HexabitzPlatform/H1FR5x-Hardware/README.md

# H1FR50-Hardware
Hexabitz SAM-M10Q GNSS Module Hardware Design
