HexabitzPlatform/H1FR5x-Hardware/H1FR50/Released/BOM/H1FR50.xlsx

 |  | www.hexabitz.com info@hexabitz.com |  |  | Bill Of Materials
Customer | Hexabitz | Revision | 0
Project | Hexabitz Modules | Date | 2022-09-11
Board | GPS Module (H1FR50) | Notes
Designator | Description | Manufacturer Part Number | Manufacturer | Octopart Url | Quantity
JP1 | PCB Header, Unshrouded, Thru 02 Straight Header, .101, AMPMODU Mod II Series | 87227-1 | TE Connectivity | https://octopart.com/87227-1-te+connectivity-39512052?r=sp | 1
JP2 | Conn Unshrouded Header HDR 3 POS 2.54mm Solder ST Top Entry Thru-Hole Carton | 5-146281-3 | TE Connectivity | https://octopart.com/5-146281-3-te+connectivity+%2F+amp-39745942?r=sp | 1
R2 | RES SMD 0.0OHM JUMPER 1/10W 0603 | RC0603JR-070RL | YAGEO [VR] | https://octopart.com/rc0603jr-070rl-yageo-1241539?r=sp | 1
R8 , R9 | Res Thick Film 0603 150 Ohm 1% 0.1W(1/10W) +/-100ppm/ßC Pad SMD Automotive T/R | CRCW0603150RFKEA | Vishay | https://octopart.com/crcw0603150rfkea-vishay-39455211?r=sp | 2
R3 | Thick Film Resistors - SMD 0603 270 Ohm 5% Tol | ERJ-3GEYJ271V | Panasonic | https://octopart.com/erj-3geyj271v-panasonic-55560546?r=sp | 1
R1 , R4 , R5 , R6 , R7 | RES 10K Ohm 5% 0603 | CRCW060310K0JNEB | Vishay | https://octopart.com/crcw060310k0jneb-vishay-46603269 | 7
C1, C3 , C5 , C6 , C8, C10 , C12 | CAP CER 0.1 UF 10% X7R 0603 | C0603C104K8RACTU | KEMET | https://octopart.com/c0603c104k8ractu-kemet-145075?r=sp&s=9bS9ASSwSEqMCE9KBEQZ0g | 7
C4 | CAP CER 1 UF 16V X7R 0805 | CC0805KKX7R7BB105 | YAGEO [VA] | https://octopart.com/cc0805kkx7r7bb105-yageo-8376555?r=sp | 1
C2 ,C7 , C9 , C11 , C13 | CAP TANT 4.7 UF 10V 20% 0805 | 10TPU4R7MSI | Panasonic | https://octopart.com/10tpu4r7msi-panasonic-29487748?r=sp | 5
FB1 | Ind chip Bead Multi-Layer 30 ohms 25% 100MHZ Ferrite 1,5A 0603Punched paper T/R | MMZ1608Y300BTA00 | TDK | https://octopart.com/mmz1608y300bta00-tdk-7906990?r=sp | 1
FB2 , FB3 | Ferrite Beads Multi-Layer 600Ohm 25% 100MHz 1.3A 150mOhm DCR 0603 Paper T/R | BLM18KG601SN1D | Murata | https://octopart.com/blm18kg601sn1d-murata-12276433?r=sp | 2
D1 | Red 0603 130° Clear 54 mcd 2 V Surface Mount ChipLED | VLMS1300-GS08 | Vishay | https://octopart.com/vlms1300-gs08-vishay-21709201?r=sp&s=0nXJNjGsSbWwqfqWlZv0EA | 1
Q1 , Q2 | Transistor, Bipolar, Si, NPN, General Purpose, VCEO 40VDC, IC 200mA, PD 225mW, SOT-23 | MMBT3904LT1G | ON Semiconductor | https://octopart.com/mmbt3904lt1g-on+semiconductor-3280?r=sp | 2
U1 | MCU 32-Bit ARM Cortex-M0+ RISC 512kByte Flash 1.7V to 3.6V 48-Pin UFQFPN Tray | STM32G0B1CEU6N | STMicroelectronics | https://octopart.com/stm32g0b1ceu6n-stmicroelectronics-116364672?r=sp | 1
U2 | u-blox M10 GNSS antenna module ROM, TCXO, SAW, LNA LGA | SAM-M10Q-00B | u-blox | https://octopart.com/sam-m10q-00b-u-blox-130040883?r=sp | 1
X1 | 8,0000MHZ 33pF SMD MURATA Resonators | CSTNE8M00G550000R0 | Murata | https://octopart.com/cstne8m00g550000r0-murata-91406934?r=sp | 1
