HexabitzPlatform/H1FR5x-Hardware/H1FR50/Documentation/H1FR50.pdf

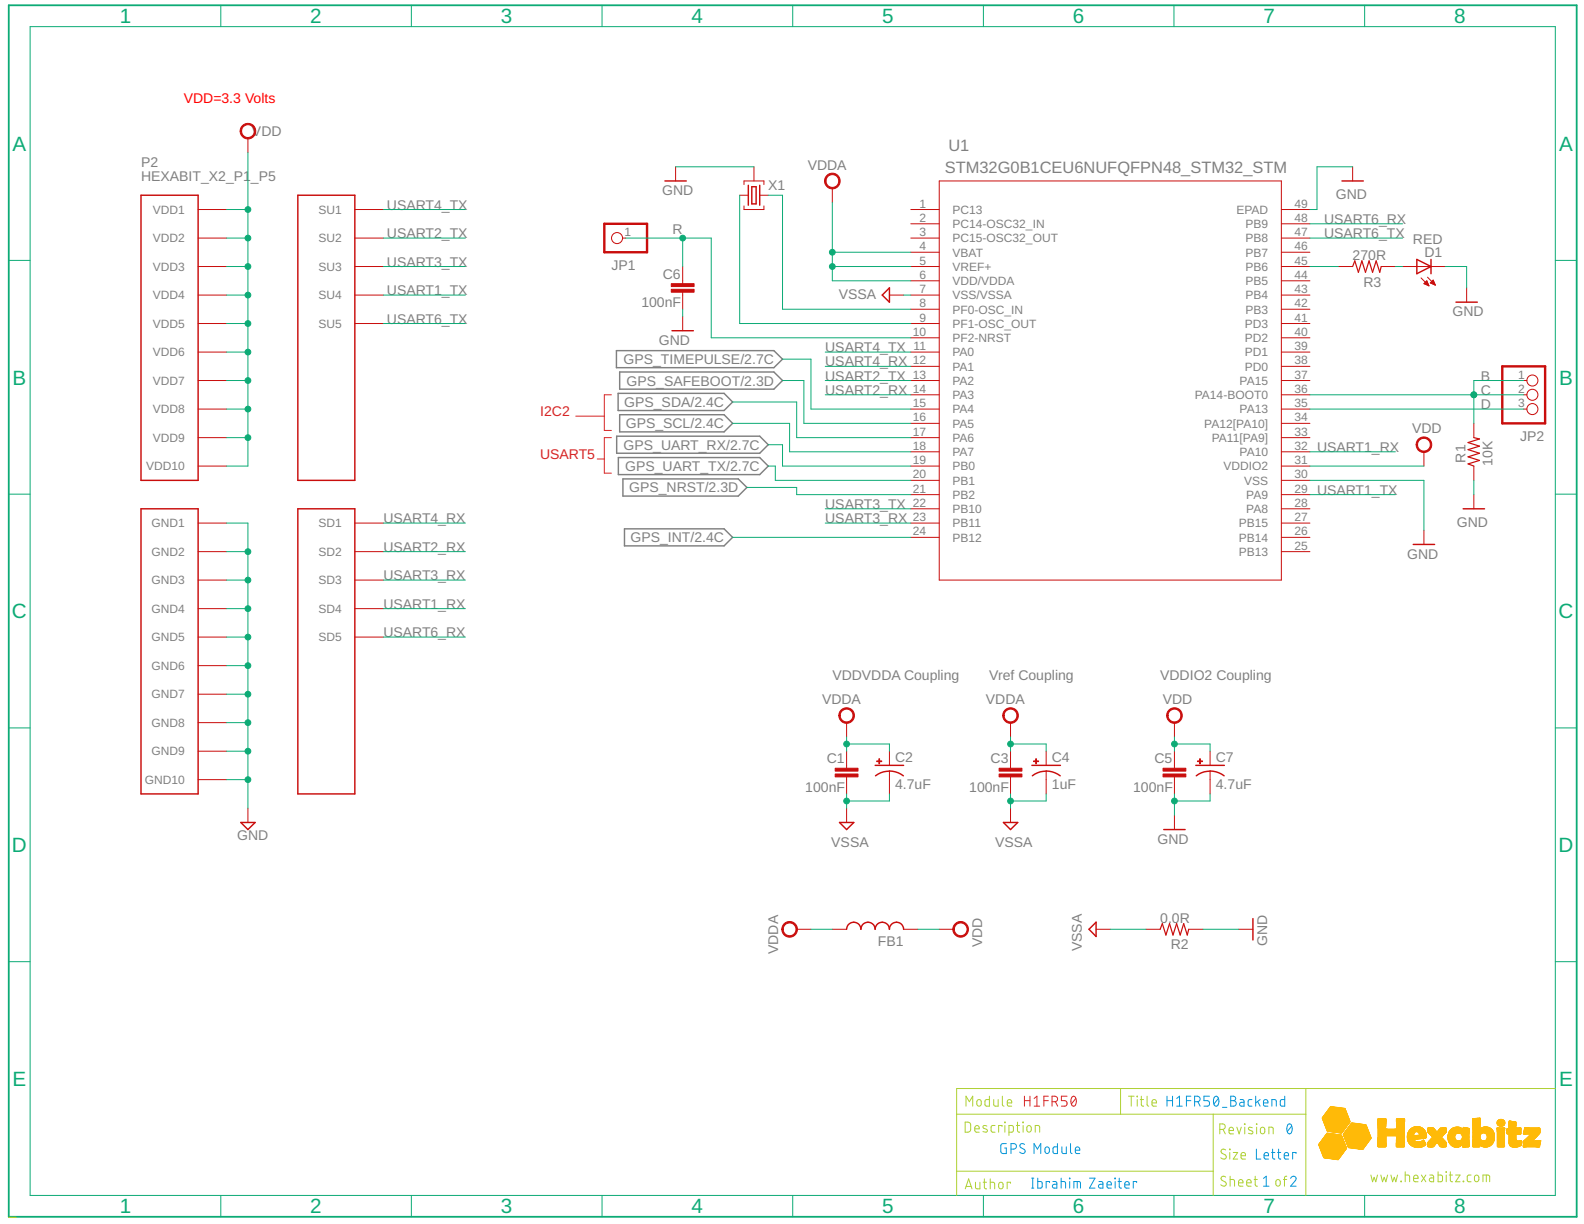
[picture p1: page 1]

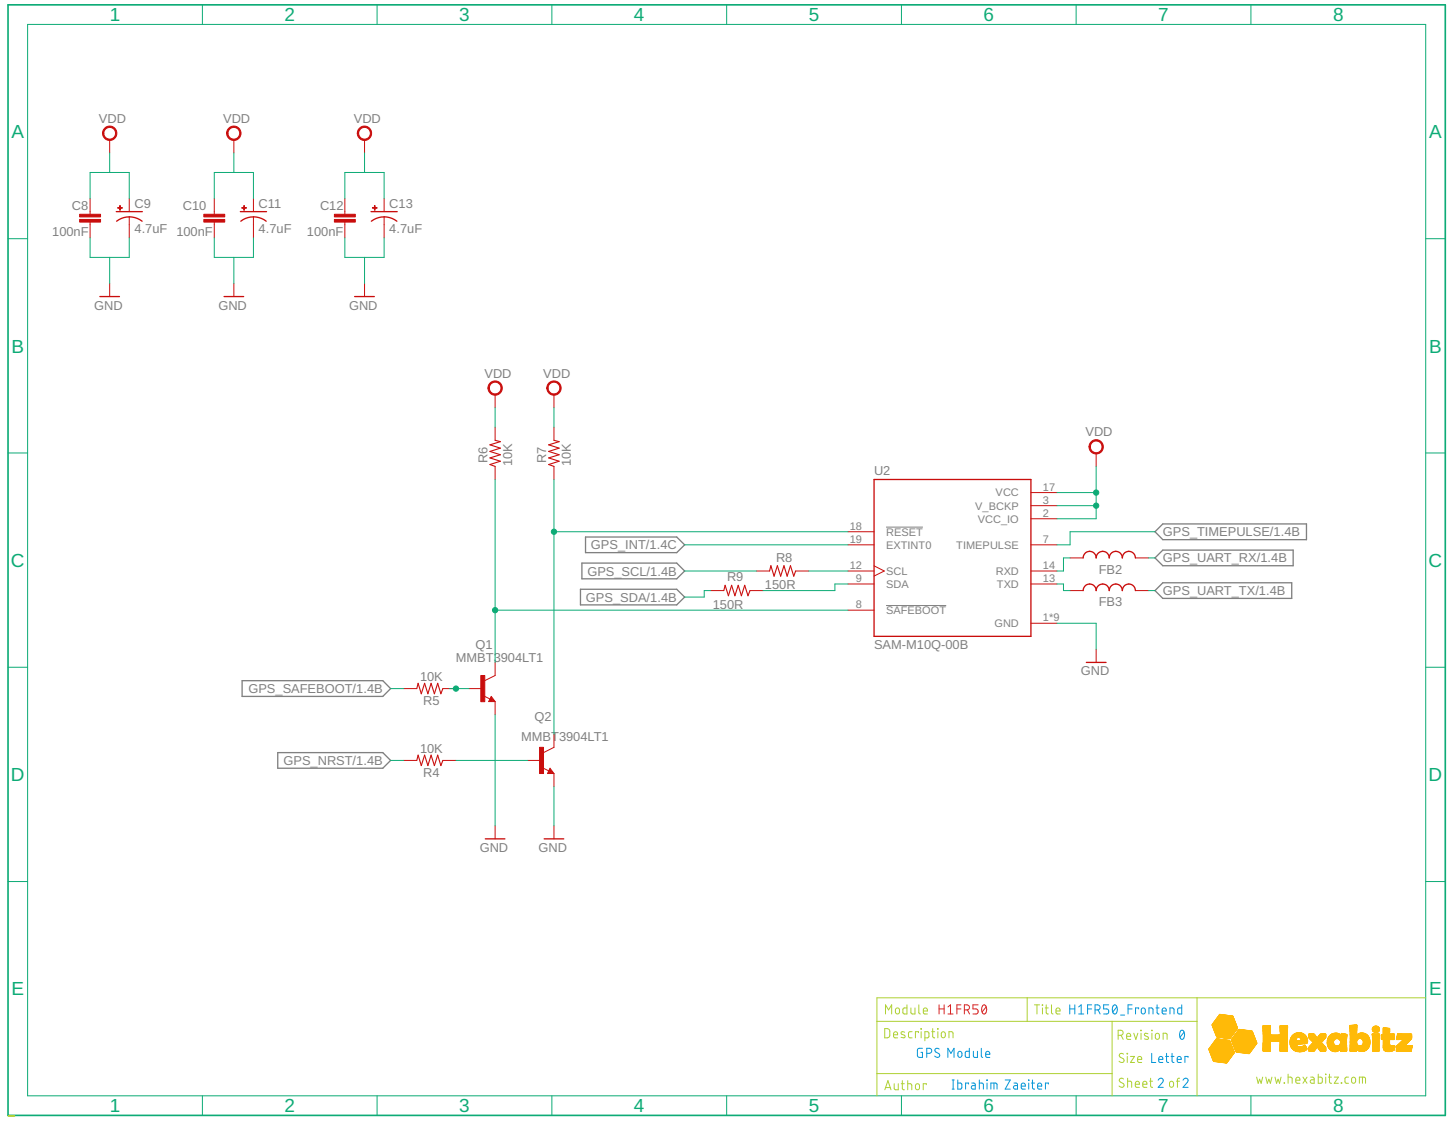
[picture p2: page 2]
