HexabitzPlatform/H1FR5x-Hardware/H1FR50/Design/H1FR50.brd

## EAGLE design H1FR50/Design/H1FR50.brd (2023-09-28)

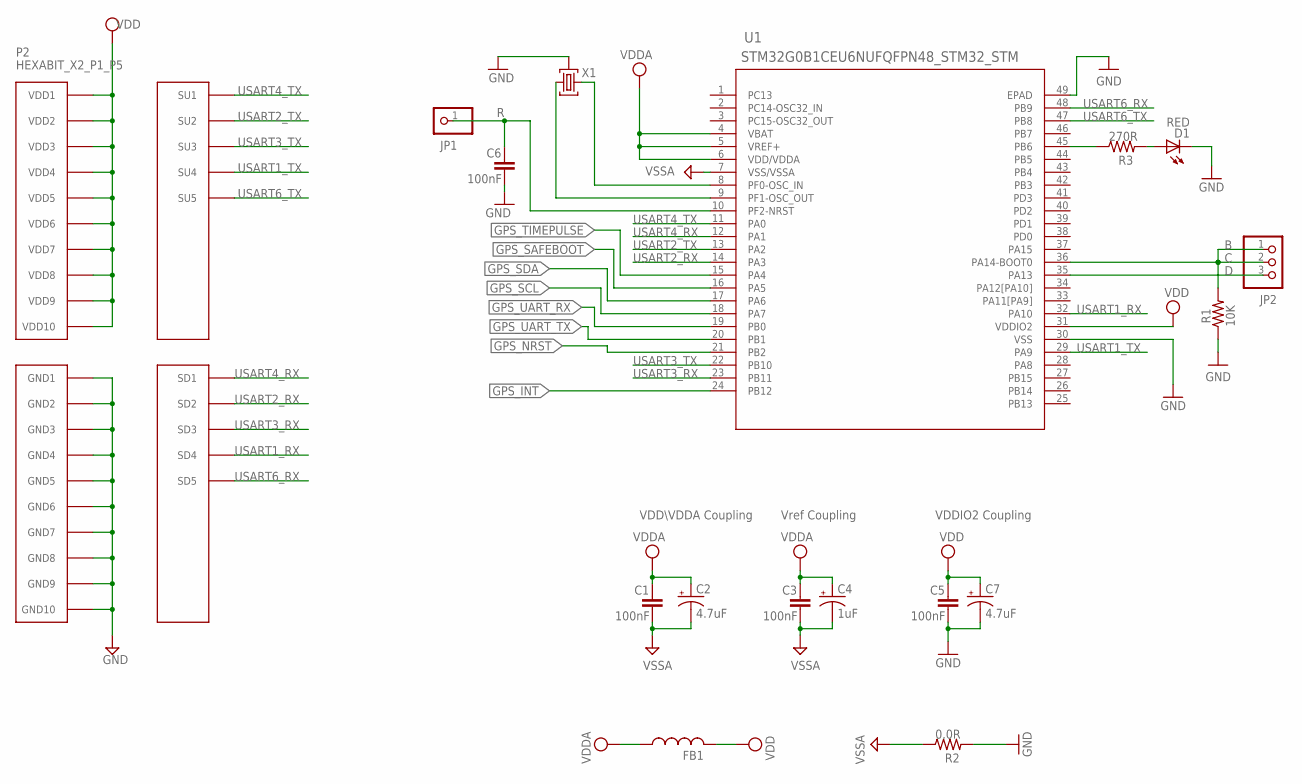
[picture p3: schematic H1FR50.sch, sheet 1]

Parts:
C1, C3, C5, C6: 100nF; C-0603
C2, C7: 4.7uF; C-0805-POL
C4: 1uF; C-0805-POL
D1: RED; VLMS1300-GS08
FB1: FB-0603
JP1: R; 1X01
JP2: PINHD-1X3; 1X03
P2: HEXABIT_X2_P1_P5; HEXABIT_17.32_X2_P1_P5
R1: 10K; R-0603
R2: 0.0R; R-0603
R3: 270R; R-0603
U1: STM32G0B1CEU6NUFQFPN48_STM32_STM; UFQFPN48_STM32_STM
X1: XTALL_CSTCE8M00G52

Connections:
C: JP2.1, JP2.2, R1.2, U1.36 (PA14-BOOT0)
D: JP2.3, U1.35 (PA13)
GND: C5.2, C6.2, C7.2 (-), D1.C, P2.PAD_PD11 (GND1), P2.PAD_PD12 (GND2), P2.PAD_PD13 (GND3), P2.PAD_PD14 (GND4), P2.PAD_PD15 (GND5), P2.PAD_PD16 (GND6), P2.PAD_PD17 (GND7), P2.PAD_PD18 (GND8), P2.PAD_PD19 (GND9), P2.PAD_PD20 (GND10), R1.1, R2.2, U1.30 (VSS), U1.49 (EPAD), X1.P$2 (2); also elsewhere on the board
GPS_INT: U1.24 (PB12); also elsewhere on the board
GPS_NRST: U1.21 (PB2); also elsewhere on the board
GPS_SAFEBOOT: U1.16 (PA5); also elsewhere on the board
GPS_SCL: U1.18 (PA7); also elsewhere on the board
GPS_SDA: U1.17 (PA6); also elsewhere on the board
GPS_TIMEPULSE: U1.15 (PA4); also elsewhere on the board
GPS_UART_RX: U1.19 (PB0); also elsewhere on the board
GPS_UART_TX: U1.20 (PB1); also elsewhere on the board
unnamed: D1.A, R3.2
unnamed: U1.8 (PF0-OSC_IN), X1.P$1 (1)
unnamed: U1.9 (PF1-OSC_OUT), X1.P$3 (3)
unnamed: C6.1, JP1.1, U1.10 (PF2-NRST)
unnamed: R3.1, U1.45 (PB6)
USART1_RX: P2.PAD_PD4 (SD4), U1.32 (PA10)
USART1_TX: P2.PAD_PU4 (SU4), U1.29 (PA9)
USART2_RX: P2.PAD_PD2 (SD2), U1.14 (PA3)
USART2_TX: P2.PAD_PU2 (SU2), U1.13 (PA2)
USART3_RX: P2.PAD_PD3 (SD3), U1.23 (PB11)
USART3_TX: P2.PAD_PU3 (SU3), U1.22 (PB10)
USART4_RX: P2.PAD_PD1 (SD1), U1.12 (PA1)
USART4_TX: P2.PAD_PU1 (SU1), U1.11 (PA0)
USART6_RX: P2.PAD_PD5 (SD5), U1.48 (PB9)
USART6_TX: P2.PAD_PU5 (SU5), U1.47 (PB8)
VDD: C5.1, C7.1 (+), FB1.2, P2.PAD_PU11 (VDD1), P2.PAD_PU12 (VDD2), P2.PAD_PU13 (VDD3), P2.PAD_PU14 (VDD4), P2.PAD_PU15 (VDD5), P2.PAD_PU16 (VDD6), P2.PAD_PU17 (VDD7), P2.PAD_PU18 (VDD8), P2.PAD_PU19 (VDD9), P2.PAD_PU20 (VDD10), U1.31 (VDDIO2); also elsewhere on the board
VDDA: C1.1, C2.1 (+), C3.1, C4.1 (+), FB1.1, U1.4 (VBAT), U1.5 (VREF+), U1.6 (VDD/VDDA)
VSSA: C1.2, C2.2 (-), C3.2, C4.2 (-), R2.1, U1.7 (VSS/VSSA)

Notes on the sheet:
Vref Coupling
VDDIO2 Coupling
VDD\VDDA Coupling

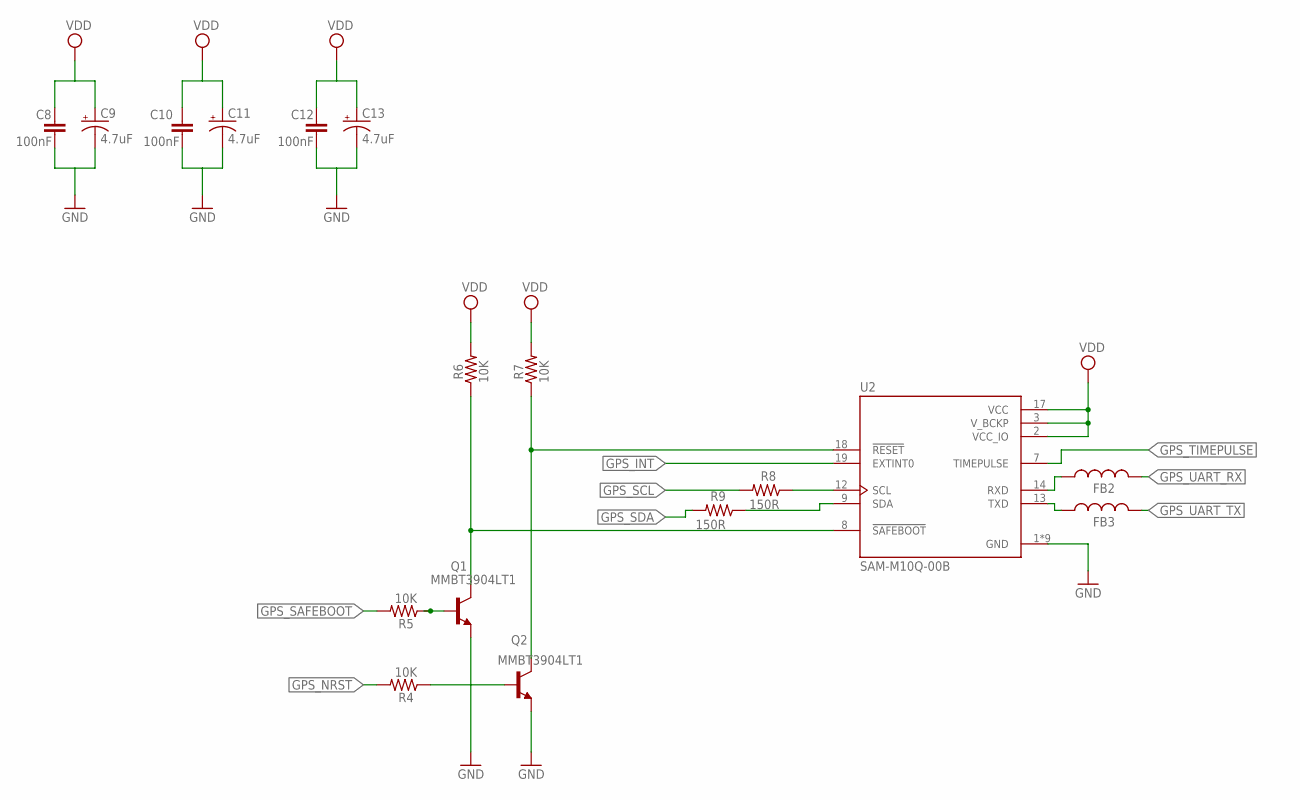
[picture p4: schematic H1FR50.sch, sheet 2]

Parts:
C8, C10, C12: 100nF; C-0603
C9, C11, C13: 4.7uF; C-0805-POL
FB2, FB3: BLM18KG601SN1D; FB-0603
Q1, Q2: MMBT3904LT1
R4, R5, R6, R7: 10K; R-0603
R8, R9: 150R; R-0603; MPN CRCW0603150RFKEA
U2: SAM-M8Q-0-10; MODULE_SAM-M8Q-0-10

Connections:
GND: C8.2, C9.2 (-), C10.2, C11.2 (-), C12.2, C13.2 (-), Q1.2 (E), Q2.2 (E), U2.1 (GND), U2.4 (GND), U2.5 (GND), U2.6 (GND), U2.10 (GND), U2.11 (GND), U2.15 (GND), U2.16 (GND), U2.20 (GND); also elsewhere on the board
GPS_INT: U2.19 (EXTINT0); also elsewhere on the board
GPS_NRST: R4.2; also elsewhere on the board
GPS_SAFEBOOT: R5.2; also elsewhere on the board
GPS_SCL: R8.2; also elsewhere on the board
GPS_SDA: R9.2; also elsewhere on the board
GPS_TIMEPULSE: U2.7 (TIMEPULSE); also elsewhere on the board
GPS_UART_RX: FB2.2; also elsewhere on the board
GPS_UART_TX: FB3.2; also elsewhere on the board
unnamed: Q2.3 (C), R7.1, U2.18 (!RESET)
unnamed: Q1.3 (C), R6.1, U2.8 (!SAFEBOOT)
unnamed: Q2.1 (B), R4.1
unnamed: Q1.1 (B), R5.1
unnamed: FB2.1, U2.14 (RXD)
unnamed: FB3.1, U2.13 (TXD)
unnamed: R8.1, U2.12 (SCL)
unnamed: R9.1, U2.9 (SDA)
VDD: C8.1, C9.1 (+), C10.1, C11.1 (+), C12.1, C13.1 (+), R6.2, R7.2, U2.2 (VCC_IO), U2.3 (V_BCKP), U2.17 (VCC); also elsewhere on the board

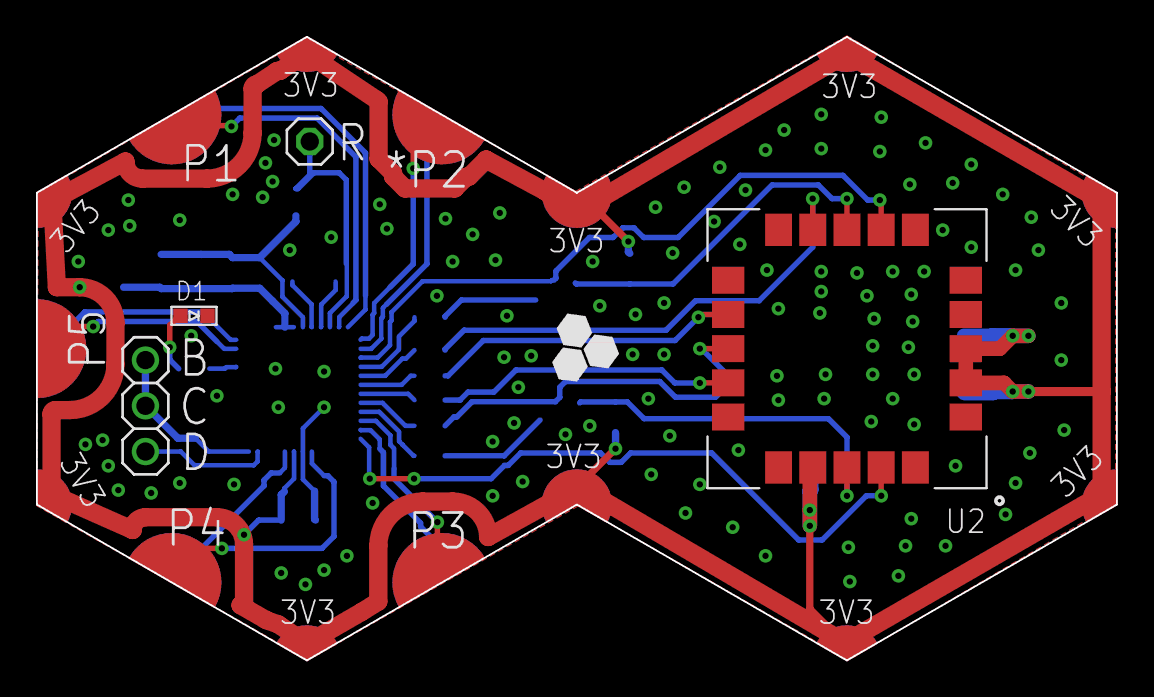
[picture p5: board H1FR50.brd from above]

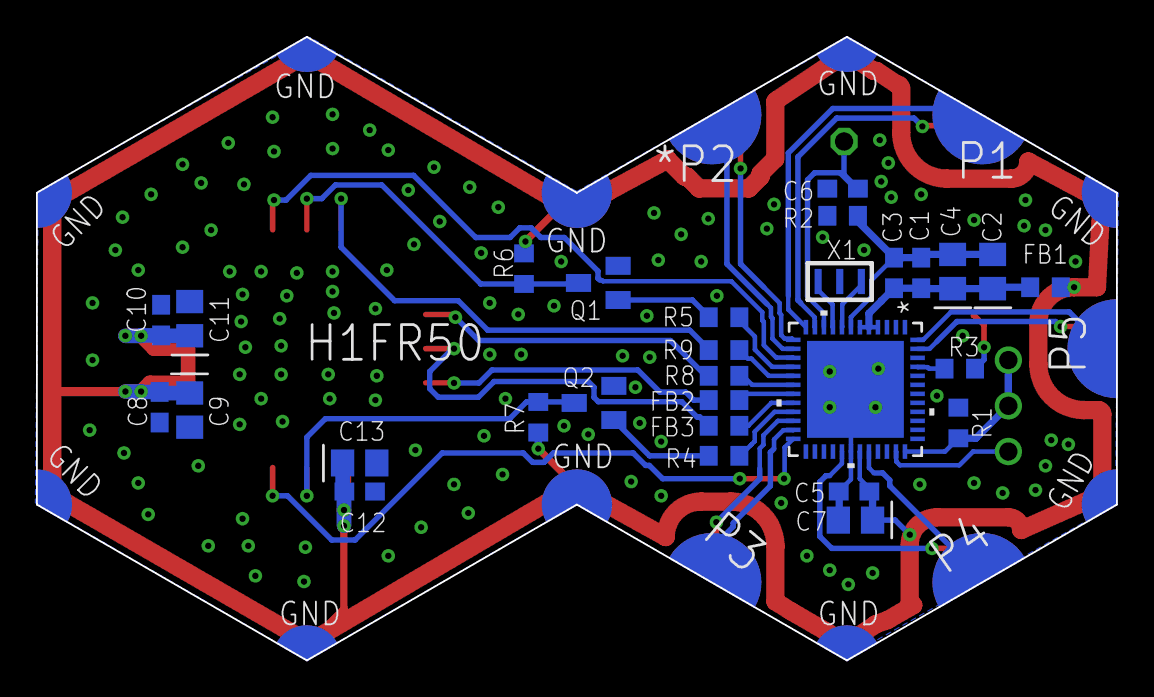
[picture p6: board H1FR50.brd from below]

Board: 2 copper layers, 60.0 x 34.6 mm, 34 parts (29 on the bottom side), 37 nets.
